WeSpeakEnglish/pollutag_node2/PCB/BOM_PCB_PCB_2026-05-13.xlsx

Quantity | Designator | Comment | Footprint | Manufacturer Part | Manufacturer
6 | C1,C2,C3,C7,C8,C11 | 10uF | CAP0603 | GRM188R61C106KALD | Murata Electronics
5 | C4,C5,C6,C10,C12 | 0.1uF | CAP0603 | 06035C104KAT2A | AVX
1 | C9 | 0.22uF | CAP0603 | AC0603X7R9BB224 | KEMET
2 | D1,D2 | PMEG40T10ERX | SOD-123_L2.6-W1.7-LS3.5-RD | PMEG40T10ERX | Nexperia(安世)
1 | IC1 | LoRa-E5 | LORAE5 | 317990687 | SEEED STUDIO
1 | IC2 | MPQ3413GJ-5-AEC1-P | SOT65P280X100-8N | MPQ3413GJ-5-AEC1-P | Monolithic Power Systems (MPS)
1 | IC3 | LDCL015M33R | SOT95P280X145-5N | LDCL015M33R | STMicroelectronics
1 | IC4 | CN3791 | SOP100P600X175-10N | CN3791 | Consonance
1 | J1 | 61300511121 | HDR-TH_5P-P2.54-V-M | 61300511121 | Wurth(伍尔特)
1 | J2 | 142-0701-801 | 142-0701-801 | 142-0701-801 | Cinch Connectivity Solutions
1 | J3 | SM06B-GHS-TB_LF__SN_ | SM06B-GHS-TB | SM06B-GHS-TB(LF)(SN) | JST (JAPAN SOLDERLESS TERMINALS)
1 | L1 | 2.2uH | IND-SMD_L3.0-W3.0_SRN3015 | SRN3015-2R2M | Bourns
1 | L2 | 10uH | IND-SMD_L3.0-W3.0_SRN3015 | SRN3015BTA-100M | Bourns
2 | LED1,LED2 | LTST-C171YKT | LEDC2012X90N | LTST-C171YKT | Lite-On
1 | Q1 | PMV41XPAR | SOT-23-3_L2.9-W1.6-P1.90-LS2.8-BR | PMV41XPAR | Nexperia
1 | Q2 | AO3400A | SOT-23-3_L2.9-W1.6-P1.90-LS2.8-BR | AO3400A | Alpha & Omega Semiconductors
3 | R1,R7,R10 | 2k | R0603 | RC0603FR-072KL | Yageo
4 | R2,R6,R8,R11 | 30k | R0603 | CR0603-FX-3002ELF | Bourns
1 | R3 | 0.1 | RESC3216X70N | CRL1206FWR100ELF | Bourns
2 | R4,R9 | 82k | R0603 | RT0603FRE0782KL | KEMET
1 | R5 | 120 | R0603 | ERJ-U03J121V | Panasonic
