WeSpeakEnglish/pollutag_node2/PCB/3D_PCB_2026-10-08.step

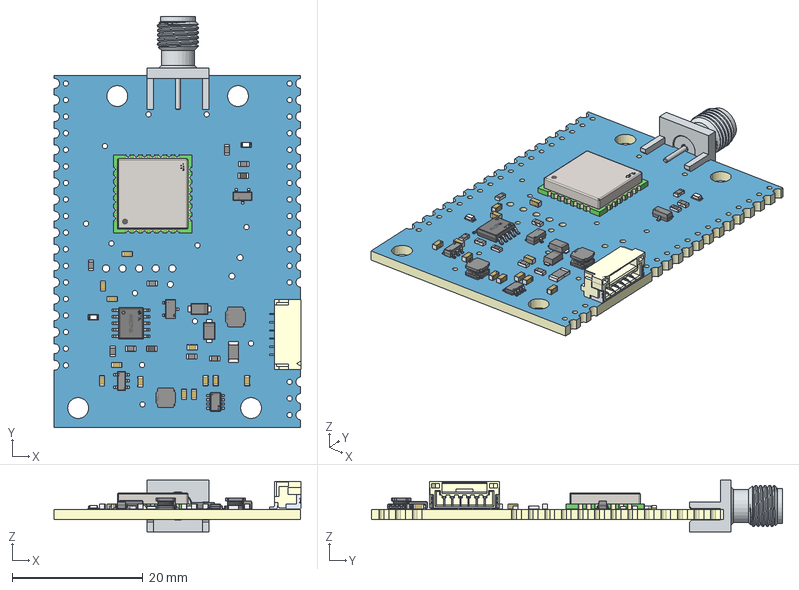
[picture p2: CAD file, 2026-10-08]
PCB/3D_PCB_2026-10-08.step
37.8 x 63.0 x 7.92 mm
Board~BfUS
TopCopper~BfUS
BottomCopper~BfUS
TopSilkscreen~BfUS
BottomSilkscreen~BfUS
TopFpcStiffener~BfUS
BottomFpcStiffener~BfUS
R0603~R0603_L1.6-W0.8-H0.5~G2VT x 8
SOD-123_L2.6-W1.7-LS3.5-RD~SOD-123_L2.6-W1.7-LS3.5-RD~XJwP x 2
CAP0603~C0603~WAW4 x 12
142-0701-801~142-0701-851~gsIk
LEDC2012X90N~LED0603-RD_RED~FeYq x 2
LORAE5~SMD-28_L12.0-W12.0-P1.25_LORA-E5~oMJc
IND-SMD_L3.0-W3.0_SRN3015~IND-SMD_L3.0-W3.0_XRNR3015~8dTl x 2
RESC3216X70N~R1206_L3.2-W1.6-H0.6~iSQW
SM06B-GHS-TB~SM06B-GHS-TB_LF__SN_~HgdY
R0603~Resistor_0603~R6mq x 8
SOT95P280X145-5N~SOT-23-5_L2.9-W1.3-P0.95-LS2.4-BL~TEDE
SOT65P280X100-8N~TSOT23-8_L2.9-W1.6-P0.65-LS2.8-BL~HCZR
SOP100P600X175-10N~SSOP-10_L4.8-W3.8-H1.3-LS5.8-P1.00~WW0N
SOT-23-3_L2.9-W1.6-P1.90-LS2.8-BR~SOT-23-3_L2.9-W1.3-P0.95-LS2.4-BL~qSLo
SOT-23-3_L2.9-W1.6-P1.90-LS2.8-BR~SOT-23-3_L2.9-W1.5-P1.90-LS2.6-BL~kRxA
