WeSpeakEnglish/pollutag_node2/LASER_CUT/laser1-Sketch.dxf

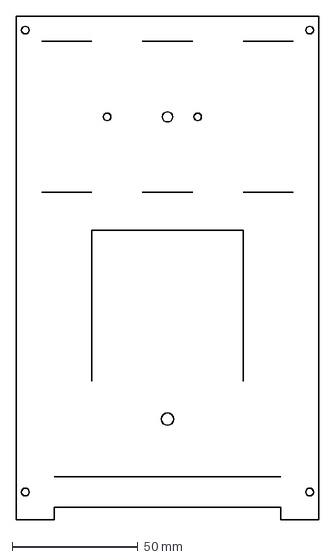
[picture p3: CAD file, 2026-05-13]
LASER_CUT/laser1-Sketch.dxf
120.0 x 200.0 mm
