WeSpeakEnglish/pollutag_node2/(list of files, cad)

Other CAD files:
LASER_CUT/laser1.FCStd
