WeSpeakEnglish/pollutag_node2/commissioning.png

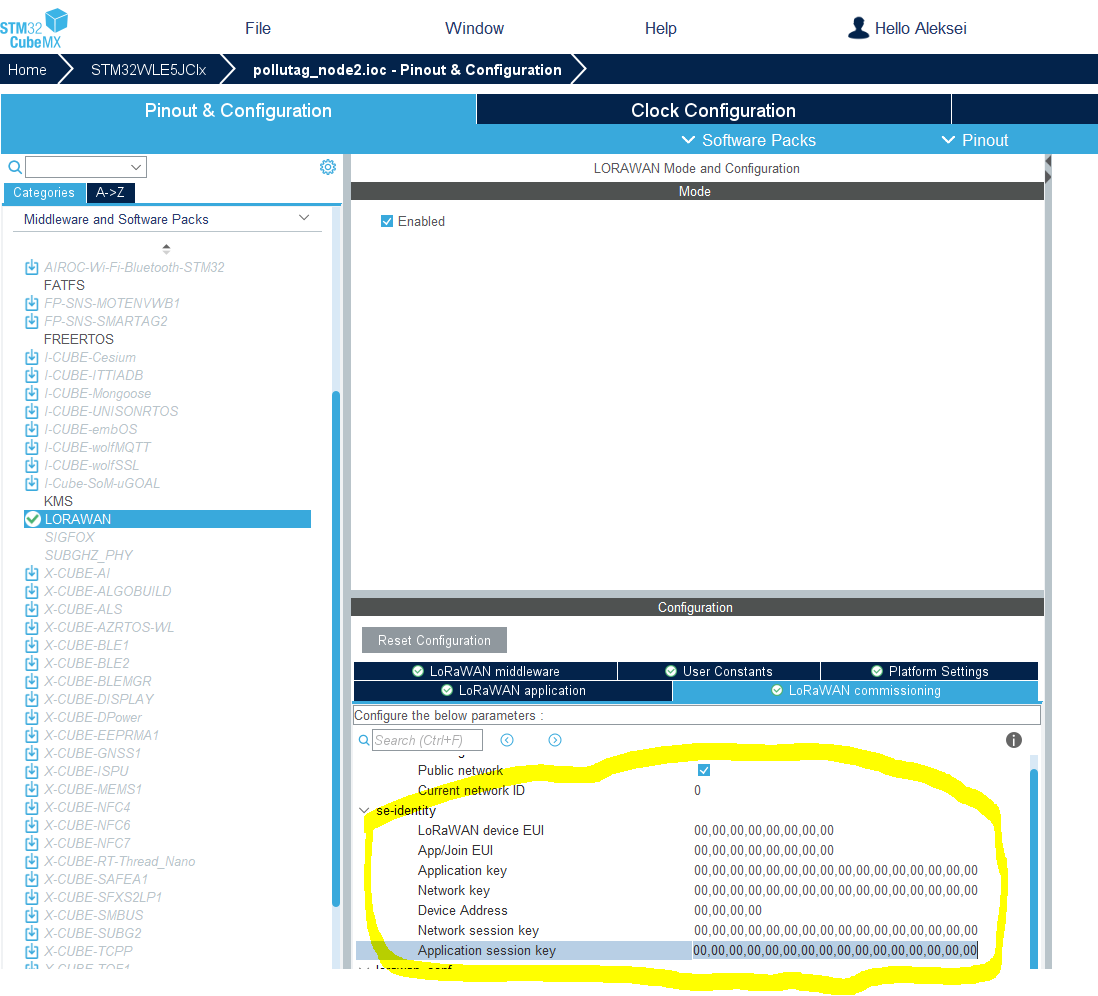
commissioning.png
