WeSpeakEnglish/pollutag_node2/PCB/SCH_pollutagNode2_2026-05-13.pdf

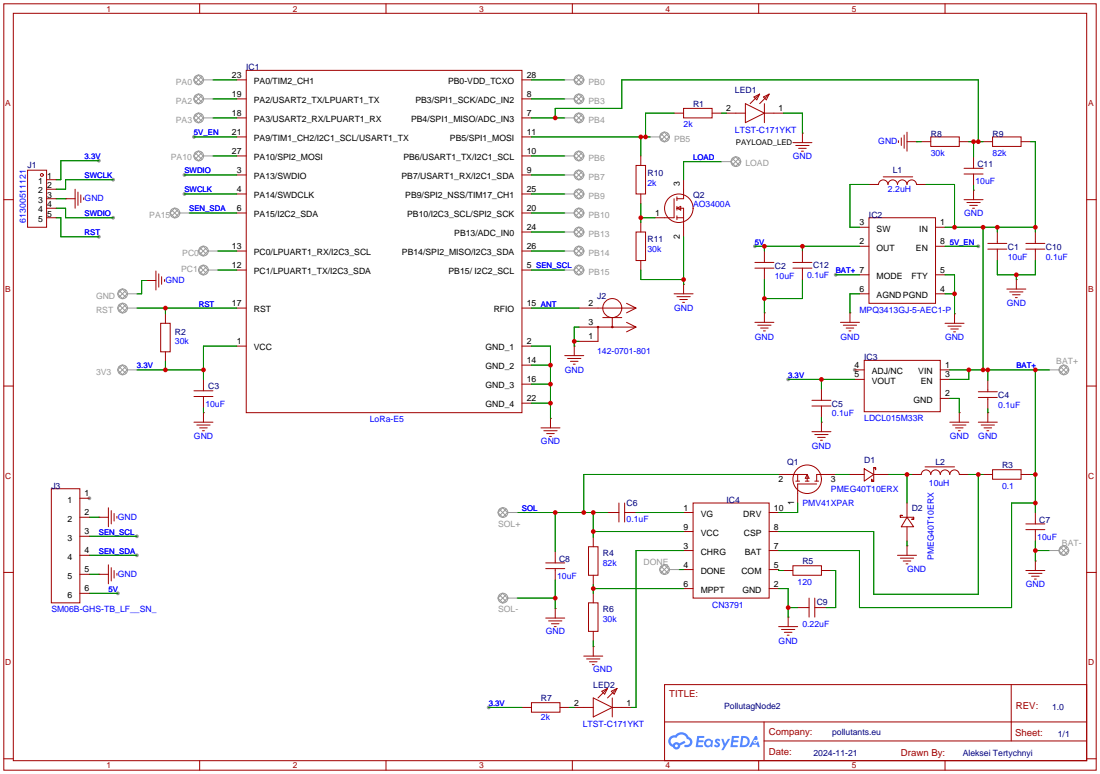
[picture p5: page 1]
