WeSpeakEnglish/pollutag_node2/(list of files, drawings)

Other design files:
PCB/PollutagNode2_rev4_2026-10-08.epro
