WeSpeakEnglish/pollutag_node2/PCB/kicad/pollutag_node2.kicad_pcb

## KiCad design PCB/kicad/pollutag_node2.kicad_pcb (2026-10-14)

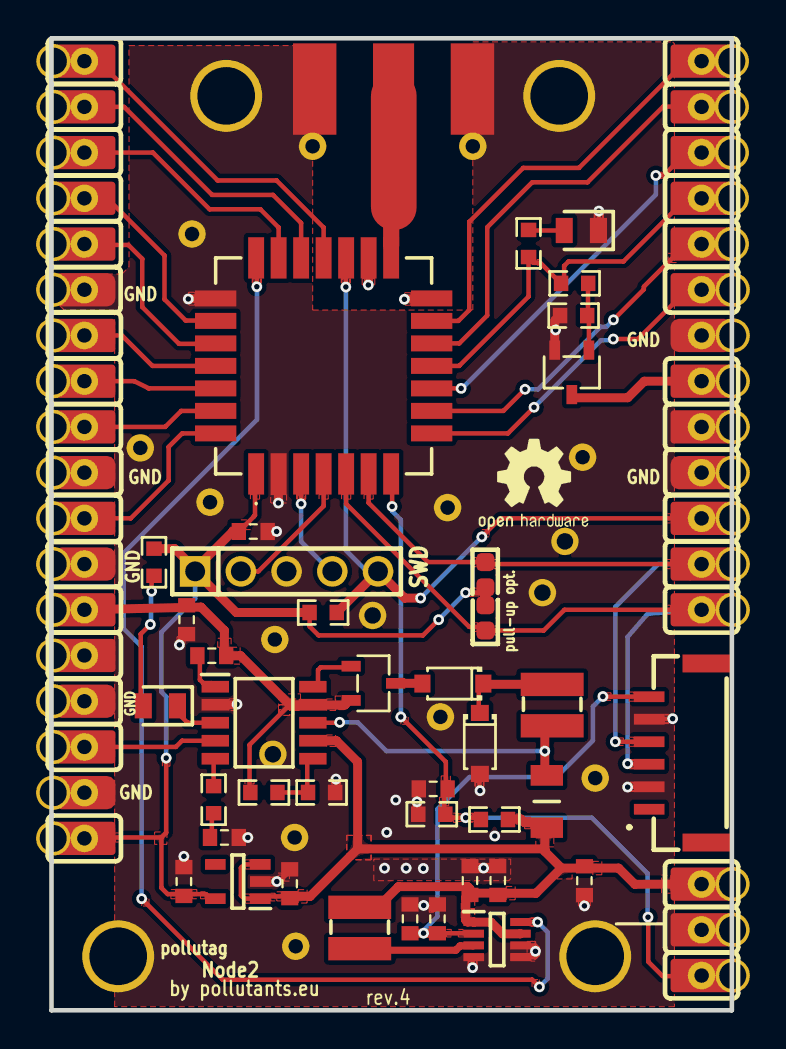
[picture p6: board pollutag_node2.kicad_pcb from above]

Board: 2 copper layers, 37.8 x 54.0 mm, 65 parts (0 on the bottom side), 43 nets.

Parts:
3V3: S1751-46R
BAT+: S1751-46R
BAT-: S1751-46R
C1, C2, C3, C4, C5, C6, C7, C8, C9, C10, C11, C12: CAP0603
D1, D2: SOD-123_L2.6-W1.7-LS3.5-RD
DONE: S1751-46R
GND: S1751-46R
IC1: LORAE5
IC2: SOT65P280X100-8N
IC3: SOT95P280X145-5N
IC4: SOP100P600X175-10N
J1: HDR-TH_5P-P2.54-V-M
J2: 142-0701-801
J3: SM06B-GHS-TB
L1, L2: IND-SMD_L3.0-W3.0_SRN3015
LED1, LED2: LEDC2012X90N
LOAD: S1751-46R
PA0, PA2, PA3, PA10, PA15: S1751-46R
PB0, PB3, PB4, PB5, PB6, PB7, PB9, PB10, PB13, PB14, PB15: S1751-46R
PC0, PC1: S1751-46R
Q1, Q2: SOT-23-3_L2.9-W1.6-P1.90-LS2.8-BR
R1, R2, R4, R5, R6, R7, R8, R9, R10, R11: R0603
R3: RESC3216X70N
RST: S1751-46R
SOL+: S1751-46R
SOL-: S1751-46R

Connections:
3.3V: 3V3.1, C3.2, C5.2, IC1.1, IC3.5, J1.1, R2.2, R7.2
5V: C2.1, C12.2, IC2.2, J3.6
5V_EN: IC1.21, IC2.8
$1N6: IC1.11, PB5.1, R1.2, R10.2
$1N7: Q2.1, R10.1, R11.2
$1N11: IC4.3, LED2.1
$1N12: C11.2, IC1.7, PB4.1, R8.2, R9.1
$1N25: IC1.12, PC1.1
$1N26: IC1.13, PC0.1
$1N28: IC1.27, PA10.1
$1N29: IC1.18, PA3.1
$1N30: IC1.19, PA2.1
$1N31: IC1.23, PA0.1
$1N32: IC1.26, PB14.1
$1N33: IC1.24, PB13.1
$1N34: IC1.20, PB10.1
$1N35: IC1.25, PB9.1
$1N36: IC1.9, PB7.1
$1N37: IC1.10, PB6.1
$1N40: IC1.8, PB3.1
$1N50: LED1.2, R1.1
$1N57: IC2.3, L1.2
$1N60: C9.2, R5.2
$1N61: IC4.5, R5.1
$1N63: IC4.8, L2.2, R3.1
$1N64: D1.1, D2.1, L2.1
$1N72: D1.2, Q1.3
$1N73: IC4.10, Q1.1
$1N75: LED2.2, R7.1
$1N76: IC4.6, R4.1, R6.2
$1N77: IC1.28, PB0.1
$1N78: C6.2, IC4.1
$1N83: DONE.1, IC4.4
ANT: IC1.15, J2.2
BAT+: BAT+.1, C1.1, C4.2, C7.2, C10.2, IC2.1, IC2.7, IC3.1, IC3.3, IC4.7, L1.1, R3.2, R9.2
GND: BAT-.1, C1.2, C2.2, C3.1, C4.1, C5.1, C7.1, C8.1, C9.1, C10.1, C11.1, C12.1, D2.2, GND.1, IC1.2, IC1.14, IC1.16, IC1.22, IC2.4, IC2.5, IC2.6, IC3.2, IC4.2, J1.3, J2.1, J2.3, J3.2, J3.5, LED1.1, Q2.2, R6.1, R8.1, R11.1, SOL-.1
LOAD: LOAD.1, Q2.3
RST: IC1.17, J1.5, R2.1, RST.1
SEN_SCL: IC1.5, J3.3, PB15.1
SEN_SDA: IC1.6, J3.4, PA15.1
SOL: C6.1, C8.2, IC4.9, Q1.2, R4.2, SOL+.1
SWCLK: IC1.4, J1.2
SWDIO: IC1.3, J1.4
