WeSpeakEnglish/pollutag_node2/FW/Core/Src/main.c

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
/* Includes ------------------------------------------------------------------*/
#include "main.h"
#include "i2c.h"
#include "app_lorawan.h"
#include "lptim.h"
#include "spi.h"
#include "usart.h"
#include "gpio.h"

/* USER CODE BEGIN Includes */
#include "app_sensor.h"
#include "lora_app.h"
/* USER CODE END Includes */


void SystemClock_Config(void);
/**
  * @brief  The application entry point.
  * @retval int
  */
int main(void)
{

  /* MCU Configuration--------------------------------------------------------*/

  /* Reset of all peripherals, Initializes the Flash interface and the Systick. */
  HAL_Init();

  /* Configure the system clock */
  SystemClock_Config();

  /* Initialize all configured peripherals */
  MX_GPIO_Init();
  MX_LoRaWAN_Init();
  MX_USART2_UART_Init();
  MX_I2C2_Init();
  MX_SPI2_Init();
  MX_LPTIM1_Init();
  /* USER CODE BEGIN 2 */
  AppSensor_Init(LoRaWAN_OnMeasurementDone);

  /* 1 s tick for the measurement cycle:
   * LSE 32768 Hz / 128 = 256 Hz, ARR = 255 -> compare match every 256 ticks */
  HAL_LPTIM_TimeOut_Start_IT(&hlptim1, 255, 0);
  /* USER CODE END 2 */

  /* Infinite loop */
  /* USER CODE BEGIN WHILE */
  while (1)
  {
    /* USER CODE END WHILE */
    MX_LoRaWAN_Process();

    /* USER CODE BEGIN 3 */
  }
  /* USER CODE END 3 */
}

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
/* USER CODE BEGIN 4 */
/**
  * @brief LPTIM1 compare match: 1 s tick for the sensor measurement cycle
  */
void HAL_LPTIM_CompareMatchCallback(LPTIM_HandleTypeDef *hlptim)
{
  if (hlptim == &hlptim1)
  {
    AppSensor_OnSecondTick();
  }
}

/* USER CODE END 4 */
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
