WeSpeakEnglish/pollutag_node2/FW/pollutag_node2.ioc

Mcu.UserName=STM32WLE5JCIx
PA0.GPIO_Label=DBG1
PA0.Signal=GPIO_Output
PA10.Signal=SPI2_MOSI
PA13.Signal=DEBUG_JTMS-SWDIO
PA14.Signal=DEBUG_JTCK-SWCLK
PA15.Signal=I2C2_SDA
PA2.Signal=USART2_TX
PA3.Signal=USART2_RX
PA4.GPIO_Label=RF_CTRL1
PA4.Signal=GPIO_Output
PA5.GPIO_Label=RF_CTRL2
PA5.Signal=GPIO_Output
PA9.GPIO_Label=CONNECT_PM_SENSOR
PA9.Signal=GPIO_Output
PB0-VDD_TCXO.Signal=VDDTCXO
PB10.GPIO_Label=SPI_CEN
PB10.Signal=GPIO_Output
PB13.Signal=SPI2_SCK
PB14.Signal=SPI2_MISO
PB15.Signal=I2C2_SCL
PB3.GPIO_Label=DBG3
PB3.Signal=GPIO_Output
PB4.Signal=ADC_IN3
PB5.GPIO_Label=LED2
PB5.Signal=GPIO_Output
PB6.GPIO_Label=USARTx_TX
PB6.Signal=USART1_TX
PB7.GPIO_Label=USARTx_RX
PB7.Signal=USART1_RX
PB9.GPIO_Label=SPI_CSN
PB9.Signal=GPIO_Output
PC14-OSC32_IN.Signal=RCC_OSC32_IN
PC15-OSC32_OUT.Signal=RCC_OSC32_OUT
