WeSpeakEnglish/pollutag_node2/FW/LoRaWAN/App/se-identity.h

/*!
 * \file      se-identity.h
 *
 * \brief     Secure Element identity and keys
 *
 * \copyright Revised BSD License, see section \ref LICENSE.
 *
 * \code
 *                ______                              _
 *               / _____)             _              | |
 *              ( (____  _____ ____ _| |_ _____  ____| |__
 *               \____ \| ___ |    (_   _) ___ |/ ___)  _ \
 *               _____) ) ____| | | || |_| ____( (___| | | |
 *              (______/|_____)_|_|_| \__)_____)\____)_| |_|
 *              (C)2020 Semtech
 *
 *               ___ _____ _   ___ _  _____ ___  ___  ___ ___
 *              / __|_   _/_\ / __| |/ / __/ _ \| _ \/ __| __|
 *              \__ \ | |/ _ \ (__| ' <| _| (_) |   / (__| _|
 *              |___/ |_/_/ \_\___|_|\_\_| \___/|_|_\\___|___|
 *              embedded.connectivity.solutions===============
 *
 * \endcode
 *
 */
/**
  ******************************************************************************
  *
  *          Portions COPYRIGHT 2020 STMicroelectronics
  *
  * @file    se-identity.h
  * @author  MCD Application Team
  * @brief   Secure Element identity and keys
  ******************************************************************************
  */

/* Define to prevent recursive inclusion -------------------------------------*/
#ifndef __SOFT_SE_IDENTITY_H__
#define __SOFT_SE_IDENTITY_H__

#ifdef __cplusplus
extern "C" {
#endif

/* Exported Includes --------------------------------------------------------*/
/* Exported types ------------------------------------------------------------*/
/* Exported constants --------------------------------------------------------*/

/*!
 ******************************************************************************
 ********************************** WARNING ***********************************
 ******************************************************************************
  The secure-element implementation supports both 1.0.x and 1.1.x LoRaWAN
  versions of the specification.
  Thus it has been decided to use the 1.1.x keys and EUI name definitions.
  The below table shows the names equivalence between versions:
               +---------------------+-------------------------+
               |       1.0.x         |          1.1.x          |
               +=====================+=========================+
               | LORAWAN_DEVICE_EUI  | LORAWAN_DEVICE_EUI      |
               +---------------------+-------------------------+
               | LORAWAN_APP_EUI     | LORAWAN_JOIN_EUI        |
               +---------------------+-------------------------+
               | LORAWAN_GEN_APP_KEY | LORAWAN_APP_KEY         |
               +---------------------+-------------------------+
               | LORAWAN_APP_KEY     | LORAWAN_NWK_KEY         |
               +---------------------+-------------------------+
               | LORAWAN_NWK_S_KEY   | LORAWAN_F_NWK_S_INT_KEY |
               +---------------------+-------------------------+
               | LORAWAN_NWK_S_KEY   | LORAWAN_S_NWK_S_INT_KEY |
               +---------------------+-------------------------+
               | LORAWAN_NWK_S_KEY   | LORAWAN_NWK_S_ENC_KEY   |
               +---------------------+-------------------------+
               | LORAWAN_APP_S_KEY   | LORAWAN_APP_S_KEY       |
               +---------------------+-------------------------+
 ******************************************************************************
 ******************************************************************************
 ******************************************************************************
 */
/*!
 * End-device IEEE EUI (big endian)
 * When set to 00,00,00,00,00,00,00,00 DevEui is automatically set with a value provided by MCU platform
 */
#define LORAWAN_DEVICE_EUI                                 00,00,00,00,00,00,00,00

/*!
 * App/Join server IEEE EUI (big endian)
 */
#define LORAWAN_JOIN_EUI                                   00,00,00,00,00,00,00,00

/*!
 * Device address on the network (big endian)
 * When set to 00,00,00,00 DevAddr is automatically set with a value provided by MCU platform
 */
#define LORAWAN_DEVICE_ADDRESS                             00,00,00,00

/*!
 * Application root key
 */
#define LORAWAN_APP_KEY                                    00,00,00,00,00,00,00,00,00,00,00,00,00,00,00,00

/*!
 * Network root key
 */
#define LORAWAN_NWK_KEY                                    00,00,00,00,00,00,00,00,00,00,00,00,00,00,00,00

/*!
 * Forwarding Network session key
 */
#define LORAWAN_NWK_S_KEY                                  00,00,00,00,00,00,00,00,00,00,00,00,00,00,00,00

/*!
 * Application session key
 */
#define LORAWAN_APP_S_KEY                                  00,00,00,00,00,00,00,00,00,00,00,00,00,00,00,00

/*!
 * Format commissioning keys
 */
#define RAW_TO_INT8A(a,b,c,d,e,f,g,h,i,j,k,l,m,n,o,p) {0x##a,0x##b,0x##c,0x##d,\
                                                       0x##e,0x##f,0x##g,0x##h,\
                                                       0x##i,0x##j,0x##k,0x##l,\
                                                       0x##m,0x##n,0x##o,0x##p}

#define RAW8_TO_INT8A(a,b,c,d) 0x##a##b##c##d
#define RAW32_TO_INT8A(a,b,c,d,e,f,g,h) {0x##a,0x##b,0x##c,0x##d,\
                                         0x##e,0x##f,0x##g,0x##h}

#define FORMAT_KEY(...) RAW_TO_INT8A(__VA_ARGS__)
#define FORMAT8_KEY(...) RAW8_TO_INT8A(__VA_ARGS__)
#define FORMAT32_KEY(...) RAW32_TO_INT8A(__VA_ARGS__)

#if (defined( LORAMAC_VERSION ) && ( LORAMAC_VERSION == 0x01010100 ))
#define SESSION_KEYS_LIST                                                                                           \
        {                                                                                                           \
            /*!                                                                                                     \
             * Join session integrity key (Dynamically updated)                                                     \
             * WARNING: NOT USED FOR 1.0.x DEVICES                                                                  \
             */                                                                                                     \
            .KeyID    = J_S_INT_KEY,                                                                                \
            .KeyValue = { 0x00, 0x00, 0x00, 0x00, 0x00, 0x00, 0x00, 0x00, 0x00, 0x00, 0x00, 0x00, 0x00, 0x00, 0x00, \
                          0x00 },                                                                                   \
        },                                                                                                          \
        {                                                                                                           \
            /*!                                                                                                     \
             * Join session encryption key (Dynamically updated)                                                    \
             * WARNING: NOT USED FOR 1.0.x DEVICES                                                                  \
             */                                                                                                     \
            .KeyID    = J_S_ENC_KEY,                                                                                \
            .KeyValue = { 0x00, 0x00, 0x00, 0x00, 0x00, 0x00, 0x00, 0x00, 0x00, 0x00, 0x00, 0x00, 0x00, 0x00, 0x00, \
                          0x00 },                                                                                   \
        },                                                                                                          \
        {                                                                                                           \
            /*!                                                                                                     \
             * Forwarding Network session integrity key                                                             \
             * WARNING: NWK_S_KEY FOR 1.0.x DEVICES                                                                 \
             */                                                                                                     \
            .KeyID    = F_NWK_S_INT_KEY,                                                                            \
            .KeyValue = FORMAT_KEY(LORAWAN_NWK_S_KEY),                                                              \
        },                                                                                                          \
        {                                                                                                           \
            /*!                                                                                                     \
             * Serving Network session integrity key                                                                \
             * WARNING: NOT USED FOR 1.0.x DEVICES. MUST BE THE SAME AS \ref LORAWAN_F_NWK_S_INT_KEY                \
             */                                                                                                     \
            .KeyID    = S_NWK_S_INT_KEY,                                                                            \
            .KeyValue = { 0x2B, 0x7E, 0x15, 0x16, 0x28, 0xAE, 0xD2, 0xA6, 0xAB, 0xF7, 0x15, 0x88, 0x09, 0xCF, 0x4F, \
                          0x3C },                                                                                   \
        },                                                                                                          \
        {                                                                                                           \
            /*!                                                                                                     \
             * Network session encryption key                                                                       \
             * WARNING: NOT USED FOR 1.0.x DEVICES. MUST BE THE SAME AS \ref LORAWAN_F_NWK_S_INT_KEY                \
             */                                                                                                     \
            .KeyID    = NWK_S_ENC_KEY,                                                                              \
            .KeyValue = { 0x2B, 0x7E, 0x15, 0x16, 0x28, 0xAE, 0xD2, 0xA6, 0xAB, 0xF7, 0x15, 0x88, 0x09, 0xCF, 0x4F, \
                          0x3C },                                                                                   \
        },                                                                                                          \
        {                                                                                                           \
            /*!                                                                                                     \
             * Application session key                                                                              \
             */                                                                                                     \
            .KeyID    = APP_S_KEY,                                                                                  \
            .KeyValue = FORMAT_KEY(LORAWAN_APP_S_KEY),                                                              \
        },                                                                                                          \
        {                                                                                                           \
            /*!                                                                                                     \
             * Datablock MIC key                                                                                    \
             */                                                                                                     \
            .KeyID    = DATABLOCK_INT_KEY,                                                                          \
            .KeyValue = { 0x00, 0x00, 0x00, 0x00, 0x00, 0x00, 0x00, 0x00, 0x00, 0x00, 0x00, 0x00, 0x00, 0x00, 0x00, \
                          0x00 },                                                                                   \
        },
#else
#define SESSION_KEYS_LIST                                                                                           \
        {                                                                                                           \
            /*!                                                                                                     \
             * Network session key                                                                                  \
             */                                                                                                     \
            .KeyID    = NWK_S_KEY,                                                                                  \
            .KeyValue = FORMAT_KEY(LORAWAN_NWK_S_KEY),                                                              \
        },                                                                                                          \
        {                                                                                                           \
            /*!                                                                                                     \
             * Application session key                                                                              \
             */                                                                                                     \
            .KeyID    = APP_S_KEY,                                                                                  \
            .KeyValue = FORMAT_KEY(LORAWAN_APP_S_KEY),                                                              \
        },                                                                                                          \
        {                                                                                                           \
            /*!                                                                                                     \
             * Datablock MIC key                                                                                    \
             */                                                                                                     \
            .KeyID    = DATABLOCK_INT_KEY,                                                                          \
            .KeyValue = { 0x00, 0x00, 0x00, 0x00, 0x00, 0x00, 0x00, 0x00, 0x00, 0x00, 0x00, 0x00, 0x00, 0x00, 0x00, \
                          0x00 },                                                                                   \
        },
#endif /* LORAMAC_VERSION */

#if (LORAMAC_MAX_MC_CTX == 1)
#define SESSION_MC_KEYS_LIST                                                                                        \
        {                                                                                                           \
            /*!                                                                                                     \
             * Multicast group #0 root key (Dynamically updated)                                                    \
             */                                                                                                     \
            .KeyID    = MC_KEY_0,                                                                                   \
            .KeyValue = { 0x00, 0x00, 0x00, 0x00, 0x00, 0x00, 0x00, 0x00, 0x00, 0x00, 0x00, 0x00, 0x00, 0x00, 0x00, \
                          0x00 },                                                                                   \
        },                                                                                                          \
        {                                                                                                           \
            /*!                                                                                                     \
             * Multicast group #0 application session key (Dynamically updated)                                     \
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
            .KeyID    = MC_ROOT_KEY,                                                                                \
            .KeyValue = { 0x00, 0x00, 0x00, 0x00, 0x00, 0x00, 0x00, 0x00, 0x00, 0x00, 0x00, 0x00, 0x00, 0x00, 0x00, \
                          0x00 },                                                                                   \
        },                                                                                                          \
        {                                                                                                           \
            /*!                                                                                                     \
             * Multicast key encryption key (Dynamically updated)                                                   \
             */                                                                                                     \
            .KeyID    = MC_KE_KEY,                                                                                  \
            .KeyValue = { 0x00, 0x00, 0x00, 0x00, 0x00, 0x00, 0x00, 0x00, 0x00, 0x00, 0x00, 0x00, 0x00, 0x00, 0x00, \
                          0x00 },                                                                                   \
        },                                                                                                          \
        SESSION_MC_KEYS_LIST                                                                                        \
        {                                                                                                           \
            /*!                                                                                                     \
             * All zeros key. (ClassB usage)(constant)                                                              \
             */                                                                                                     \
            .KeyID    = SLOT_RAND_ZERO_KEY,                                                                         \
            .KeyValue = { 0x00, 0x00, 0x00, 0x00, 0x00, 0x00, 0x00, 0x00, 0x00, 0x00, 0x00, 0x00, 0x00, 0x00, 0x00, \
                          0x00 },                                                                                   \
        },                                                                                                          \
    }

#define SOFT_SE_ID_LIST                                                                                             \
    .SeNvmDevJoinKey.DevEui = FORMAT32_KEY(LORAWAN_DEVICE_EUI),                                                     \
    .SeNvmDevJoinKey.JoinEui = FORMAT32_KEY(LORAWAN_JOIN_EUI),                                                      \
    .SeNvmDevJoinKey.DevAddrOTAA = FORMAT8_KEY(LORAWAN_DEVICE_ADDRESS),                                             \
    .SeNvmDevJoinKey.DevAddrABP = FORMAT8_KEY(LORAWAN_DEVICE_ADDRESS)                                               \

/* USER CODE BEGIN EC */
/* Per-device LoRaWAN credentials (see lorawan_credentials_template.h).
 * They override the CubeMX-generated values above, so the .ioc keeps zeros. */
#if __has_include("lorawan_credentials.h")
#undef LORAWAN_DEVICE_EUI
#undef LORAWAN_JOIN_EUI
#undef LORAWAN_APP_KEY
#undef LORAWAN_NWK_KEY
#include "lorawan_credentials.h"
#else
#error "Missing LoRaWAN/App/lorawan_credentials.h: copy lorawan_credentials_template.h to lorawan_credentials.h and enter the keys of your device"
#endif
/* USER CODE END EC */

#ifdef __cplusplus
}
#endif

#endif  /*  __SOFT_SE_IDENTITY_H__ */
