WeSpeakEnglish/pollutag_node2/(commit log)

2026-05-13 gerbs added
    [BOM_PCB_PCB_2026-05-13.xlsx, BOM_PCB_pollutagNode2_2026-05-13.xlsx, PickAndPlace_PCB_2026-05-13.xlsx]
2026-10-08 easyEda prj added
    [3D_PCB_2026-10-08.step, PollutagNode2_rev4_2026-10-08.epro]
2026-10-14 kicad project added
