WeSpeakEnglish/pollutag_node2/(notices)

Notices in the files:
FW/Core/Src/sys_sensors.c:
Copyright (c) 2021 STMicroelectronics.
All rights reserved.
This software is licensed under terms that can be found in the LICENSE file
FW/Core/Src/adc_if.c:
Copyright (c) 2023 STMicroelectronics.
